PiyushChoudhary-Git/Tuned-Mass-Damper/Pictures/Deflection.jpg

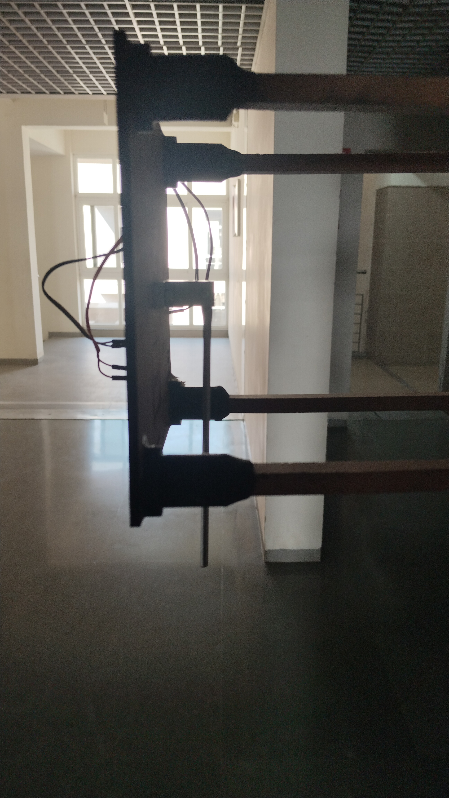
Pictures/Deflection.jpg
