PiyushChoudhary-Git/Tuned-Mass-Damper/Pictures/Model.jpg

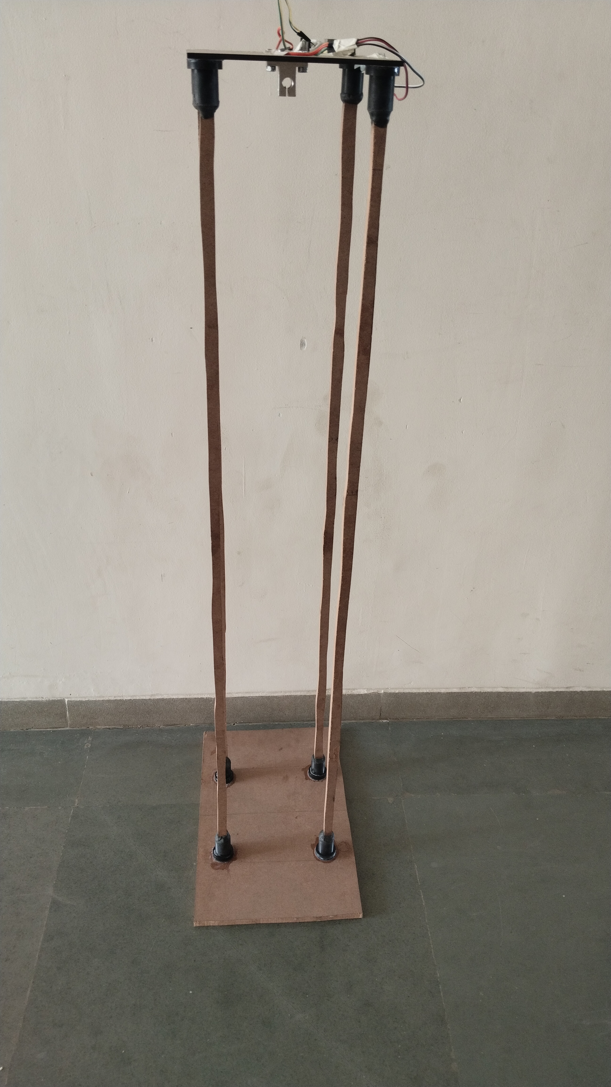
Pictures/Model.jpg
