PiyushChoudhary-Git/Tuned-Mass-Damper/CE302_Final_Report.pdf

# CE 302: Structural Analysis

### Project

### Report on

## Tuned Mass Damper

by

Team Name: STrUX

Himanshu Singh 23110134

Karthik Chandra 23110158

Piyush Choudhary 23110247

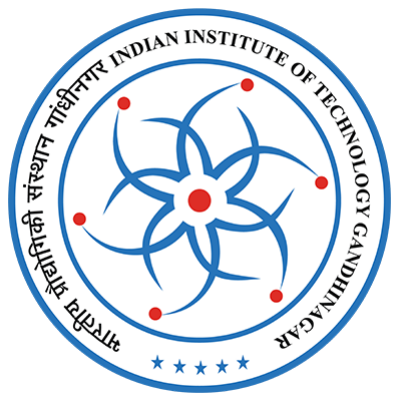
[picture p3: figure]

Indian Institute of Technology Gandhinagar

## Declaration

We, Himanshu Singh, Karthik Chandra, and Piyush Choudhary, declare that we have done the following proportion of work towards the project entitled “Tuned Mass Damper” of the Structural Analysis (CE 302) course.

Sl. No. | Name | Responsibilities | Percentage of Total Work | Signature
1 | Himanshu Singh | 3D Printed All Joints, Helped in Creating The Model, Did all the SAP Modelling | 33.33 %
2 | Karthik Chandra | Major Fabrication work and helped in report(Analytical results, summary and Conclusion) | 33.34 %
3 | Piyush Choudhary | Helped in Fabrication, Wrote the necessary Codes, Compiled the report and wrote the Experimental set-up and Comparison part | 33.33 %

## Acknowledgements

We would like to express our sincere gratitude to Prof. Manish Kumar, our course instructor for CE302 – Structural Analysis, for his valuable guidance, support, and encouragement throughout the course and this project.
We are also thankful to our Teaching Assistants, Krishnaveni Ma’am and Priya Ben Ma’am, for their continuous assistance.
Our heartfelt thanks to the Machine Shop Lab Instructors for providing us with the basic materials and technical support that were crucial for our work.
We would like to extend our gratitude to Abhhitej Singh Bhullar for kindly lending us an MDF sheet, which significantly aided in the fabrication of our model.
We are also grateful to the Tinkerer’s Lab for offering us the space and resources to carry out our project work in a conducive and creative environment.
This project would not have been possible without the support and contributions of all the above individuals and facilities.

# Contents

1 Introduction | 8
2 Analytical results | 11
3 SAP2000 model | 13
4 Experimental set-up, testing protocol and results | 19

5 Comparison of analytical and experimental results | 24
6 Summary and conclusions | 27
7 References | 28
8 Appendix | 29

# List of Tables

1.1 Components of a Tuned Mass Damper | 9
4.1 Experimental damping ratios | 23

# List of Figures

1.1 TMD in a building | 9
3.1 Initial handmade draft of the TMD system | 13
3.2 Top view of the SAP model | 14
3.3 Side view of the SAP model | 14
3.4 3D model of skyscraper with TMD (green line represents the damper) | 15
3.5 Side view of the skyscraper | 16
3.6 Deflection In The Building Due To Applied Earthquake Load | 17
3.7 Energy dissipation with TMD | 18
3.8 Energy dissipation without TMD | 18
4.1 Model without TMD | 19
4.2 Model with TMD | 19
4.3 Arduino Connections with Accelerometer [1] | 20
4.4 Acceleration Decay for Model (Without TMD) | 21
4.5 Acceleration Decay for Model (With TMD) | 21
4.6 Deflection taking the structure as Cantilevered beam | 22
5.1 Graph with and without TMD (on same scale) | 26
8.1 All the files, images and pdf version of report can be accessed here | 36

1

# Introduction

## 1.1 The Problem: Why Do Buildings Sway?

Tall structures such as skyscrapers are inherently flexible, like vertical cantilevers that oscillate when subjected to dynamic loads like wind or seismic activity. These structures possess a natural frequency (ωn), a property determined by their stiffness (k) and mass (m):

ωn =

r
k
m

When external forces (e.g., wind gusts or earthquakes) apply periodic excitation at a forcing frequency (ωext) matching the structure’s natural frequency, resonance occurs:

ωext ≈ ωn

At resonance, energy transfer to the structure becomes highly efficient, causing displacements to amplify exponentially. For lightly damped systems, this can lead to structural fatigue, occupant discomfort, or even catastrophic failure.

### 1.1.1 Amplitude of Vibration (Without a TMD)

The displacement response (x) of a building under a harmonic force F0 cos(ωt) is modeled by the damped harmonic oscillator equation:

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
+kx = F0 cos(ωt)

where c is the damping coefficient. At resonance (ω = ωn), the steady-state amplitude A reaches its maximum:
A =

F0
2mωnζ

, ζ =

c
2

√
km
Here, ζ is the damping ratio. For typical civil structures (ζ ≈ 1–5%), the amplitude A can become dangerously large, necessitating mitigation strategies.

## 1.2 The Solution: Tuned Mass Damper (TMD)

### 1.2.1 Principle of Operation

A Tuned Mass Damper (TMD) is a passive vibration control device consisting of a secondary mass (md), spring (kd), and damper (cd) installed atop a structure (see Figure 1.1). The TMD is tuned to the structure’s natural frequency (ωd = ωn), enabling it to oscillate out of phase with the building’s motion. This generates destructive interference, effectively canceling resonant vibrations.

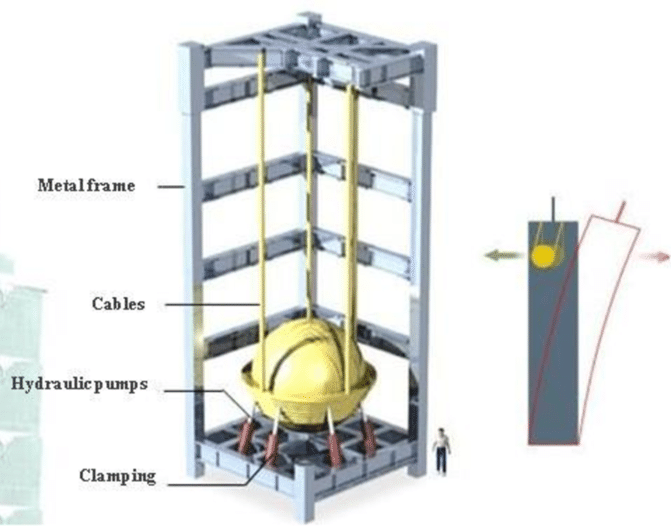
[picture p4: figure]

Figure 1.1: TMD in a building

Key Components

Component | Function
Mass | Counterweight (1–5% of structural mass) to absorb kinetic energy
Spring | p kd/md) Tuned to match the building’s natural frequency (ωd =
Damper | Dissipates energy via viscous damping, converting oscillations into heat

Table 1.1: Components of a Tuned Mass Damper

### 1.2.2 Mathematical Modeling [2]

The coupled building-TMD system is governed by two equations of motion:

Building Dynamics

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
+kx−cd

dy
dt

−

dx

dt
−kd(y−x) = F0 cos(ωt)

TMD Dynamics

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
+kd(y−x) = 0

Here, x(t) and y(t) represent the displacements of the building and TMD, respectively. The TMD exerts opposing forces proportional to the relative displacement (y−x) and velocity ( ˙y−x˙), counteracting the building’s motion.

### 1.2.3 Mechanism of Destructive Interference

When the building sways right (+x), the TMD lags by half a cycle, swaying left (−y). This phase difference of 180◦
ensures the TMD’s inertial force opposes the building’s motion:

FTMD = −kd(y−x)−cd

d
dt

(y−x)

The net force on the building becomes:

Fnet = Fwind +FTMD

thereby reducing the effective amplitude x.

### 1.2.4 Design Considerations

The TMD’s effectiveness hinges on three parameters:

1. Mass Ratio (µ = md/m):
A larger mass (typically 1–5% of the building’s mass) improves energy absorption but increases cost and space requirements.
2. Tuning Accuracy:
Mismatch between ωd and ωn drastically reduces performance. Post-construction tuning via adjustable springs/pendulums is critical.
3. Optimal Damping (ζd):
Excessive damping restricts TMD motion, while insufficient damping fails to dissipate energy. The optimal damping ratio is derived as:

ζd =

s
3µ
8(1+ µ)

### 1.2.5 Practical Applications

The Taipei 101 skyscraper employs a 660-tonne spherical TMD, reducing peak accelerations by 30–40% during typhoons. Similarly, the Citicorp Center in New York uses a 400-ton TMD to mitigate windinduced oscillations.

2

# Analytical results

## 2.1 Deflection Angle (θ)

The cantilever beam is analyzed under its self-weight (Assuming the roof and the electronic components are mass-less), modeled as a uniformly distributed load (UDL). The following parameters are considered:

- Length (L) = 1.2 m
- Breadth (b) = 1.5 cm = 0.015 m
- Depth (d) = 1 cm = 0.01 m
- Young’s Modulus (E) = 4 GPa = 4×10⁹ Pa
- Density (ρ) = 725 kg/m³
- Moment of Inertia (I) =

bd³

12

=

0.015×(0.01)

3

12

= 1.25×10⁻⁹ m⁴

- Uniformly Distributed Load (w) =

ρ·g·V
L = 725 · 9.81 ·(0.015 · 0.01) = 1.06575 N/m

The theoretical deflection angle at the free end is given by:

| θ = wL³
| 6EI

Substituting values:

θ =

1.06575×(1.2)

3
6×4×10⁹ ×1.25×10⁻⁹
| ≈ 0.06138 radians ≈ 3.5168◦

## 2.2 Natural Frequency Analysis

To assess the dynamic behavior of the beam, time-domain acceleration data was recorded for two conditions:

- With Tuned Mass Damper (TMD)
- Without Tuned Mass Damper

To evaluate the natural frequency of the beam, we analyzed the time-domain acceleration data and identified the time between the first two peaks of vibration. The time period (T) was calculated as:

T = t2 −t1

where t1 and t2 are the time values corresponding to the first and second peaks, respectively. Using the relationship:

f =

1
T
we estimated the natural frequencies for both cases. Results:
- Without TMD: Natural Frequency ≈ 2.88 Hz
- With TMD: Natural Frequency ≈ 2.50 Hz

3

# SAP2000 model

We began by carefully deciding the dimensions for our model to meet the structural and damping requirements. The initial concept was sketched by hand to finalize proportions and design intent.

## 3.1 Handmade Draft

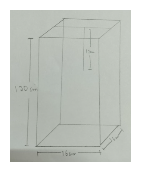
[picture p5: figure]

Figure 3.1: Initial handmade draft of the TMD system.

## 3.2 SAP2000 Modeling

After finalizing the design, we created the structure in SAP2000 using the same dimensions and configuration as the handmade draft.

### 3.2.1 Top View of the SAP Model

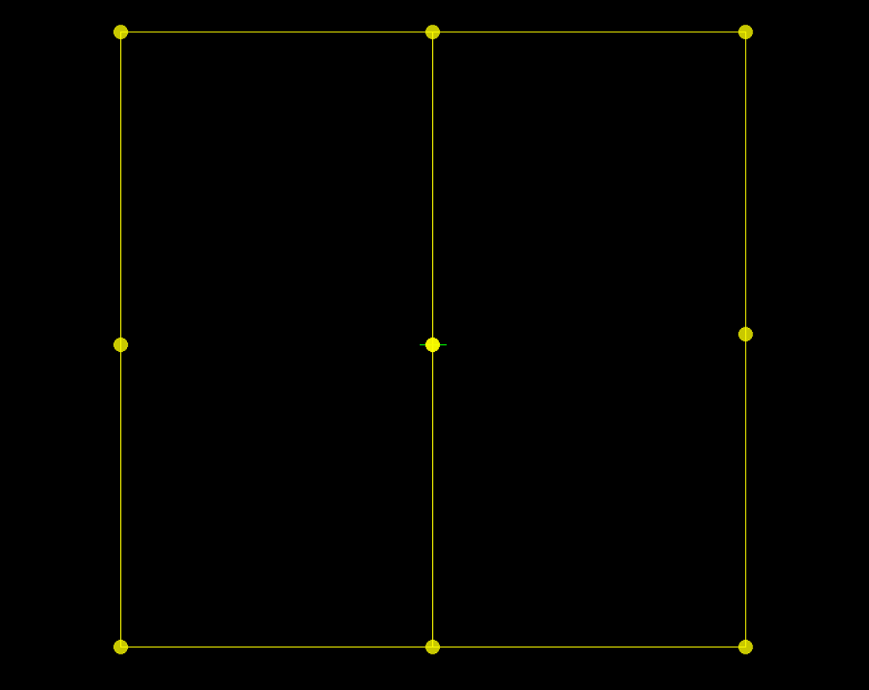
[picture p6: figure]

Figure 3.2: Top view of the SAP model.

### 3.2.2 Side View of the SAP Model

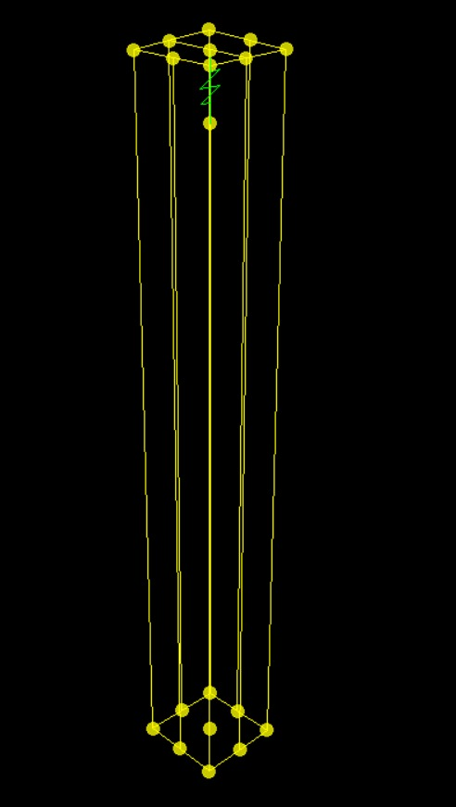
[picture p7: figure]

Figure 3.3: Side view of the SAP model.

### 3.2.3 Full Skyscraper with TMD

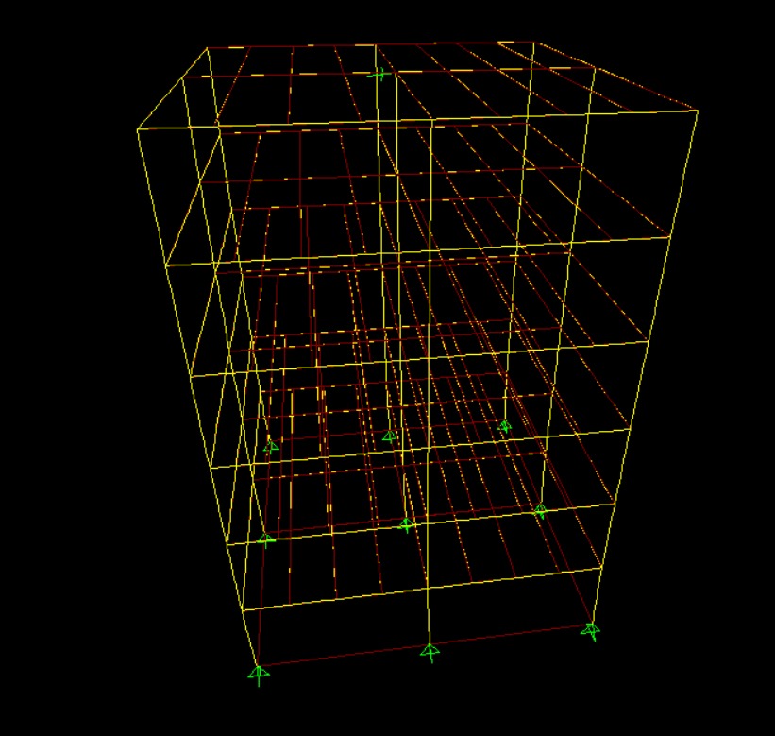
[picture p8: figure]

Figure 3.4: 3D model of skyscraper with TMD (green line represents the damper).

### 3.2.4 Side View of the Skyscraper

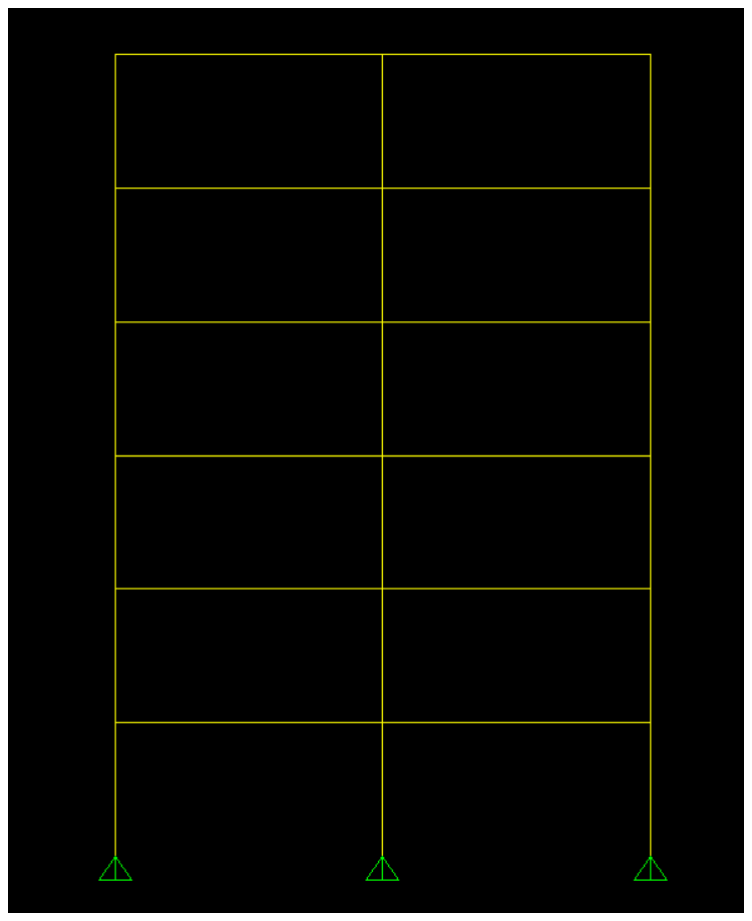
[picture p9: figure]

Figure 3.5: Side view of the skyscraper.

## 3.3 Earthquake Load Simulation

We applied earthquake loads to the structure and visualized the resulting deflections. The model responded realistically, showing clear differences in behavior with and without the TMD.

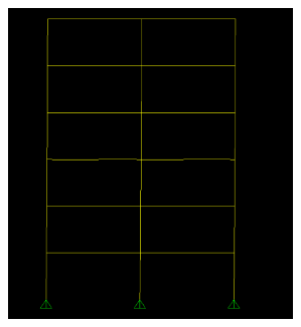
[picture p10: figure]

Figure 3.6: Deflection In The Building Due To Applied Earthquake Load.

## 3.4 Energy Dissipation Comparison

We analyzed the time taken for the building’s kinetic energy to reduce to zero, with and without the damper.

## 3.5 Observation

From the simulation results:

- With TMD: The kinetic energy reduces to zero in approximately 2.6 seconds.
- Without TMD: The building takes slightly more than 3 seconds to stabilize.

This confirms that the TMD significantly enhances the damping performance of the structure.

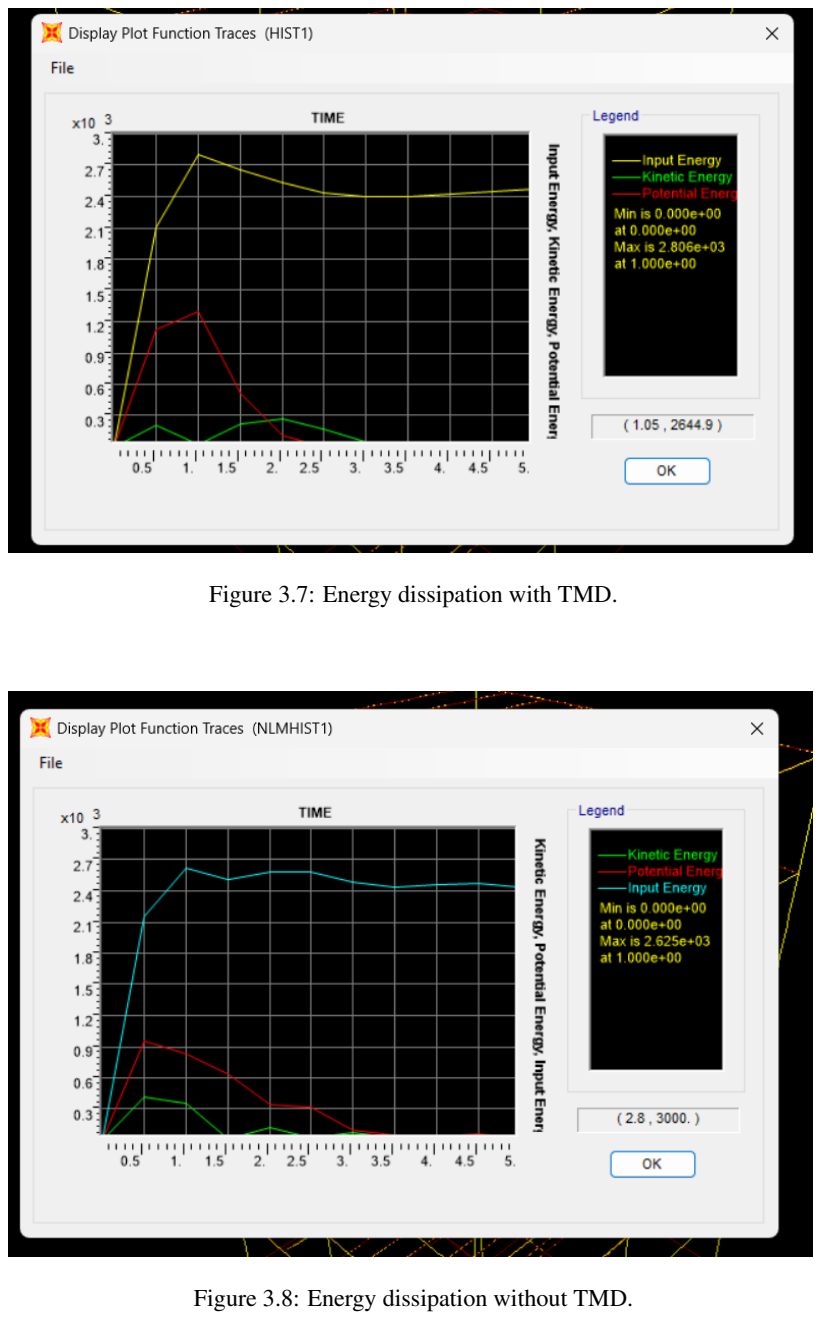
[picture p11: page 18]

Figure 3.7: Energy dissipation with TMD.

Figure 3.8: Energy dissipation without TMD.

4

# Experimental set-up, testing protocol and results

## 4.1 Experimental Setup

### 4.1.1 Physical Model

A scaled-down building model was constructed with the following components:

- Primary structure: MDF sheet was used and joints were 3D printed.
- TMD attachment: Removable mass-damper system (tuned to the model’s natural frequency).
- Sensors: Accelerometer (MPU6050) mounted at the top floor to measure lateral acceleration.
- Data acquisition: Arduino Uno programmed to sample acceleration data.

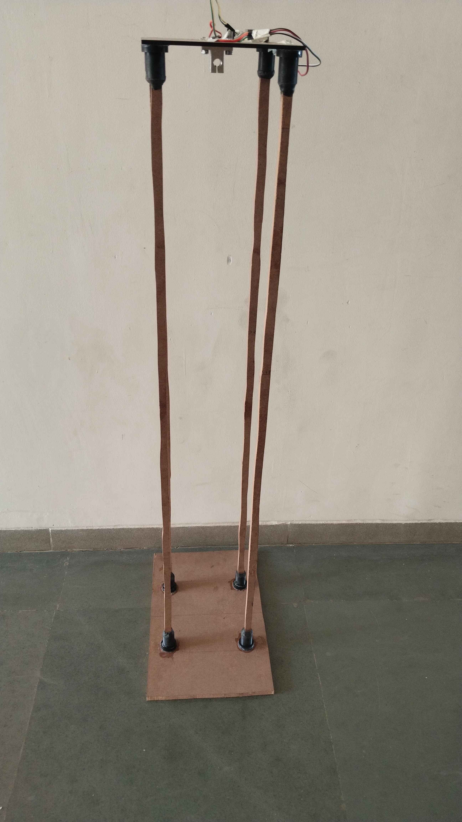
[picture p12: figure]
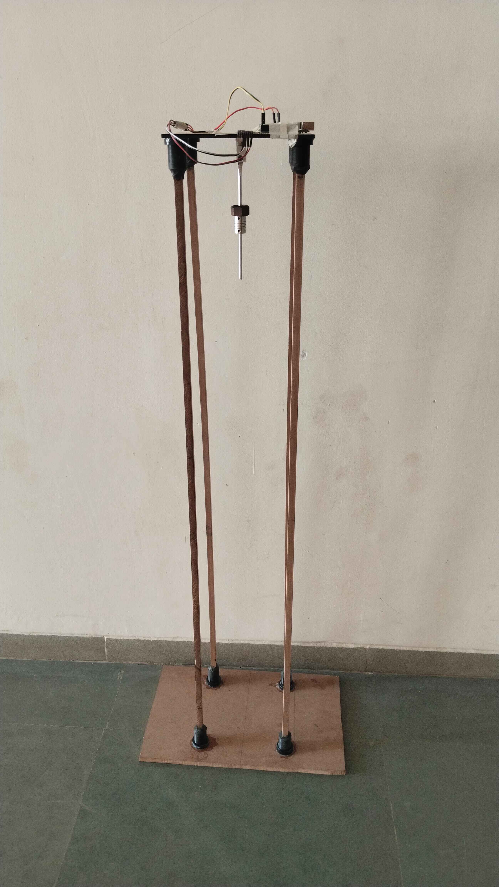
[picture p13: figure]

Figure 4.1: Model without TMD | Figure 4.2: Model with TMD

### 4.1.2 Software Tools

- Arduino IDE: Script was written to print the accelerometer data for all 3 axis. See Section 8.1 for more details.
- Python: Then python was used to filter out the data from lateral direction, plot and store the real time data (Section 8.2). Then the final code gives the Logarithmic Decrement constant (δ) and Damping Ratio (ζ ) (Section 8.3).

### 4.1.3 Arduino Connections

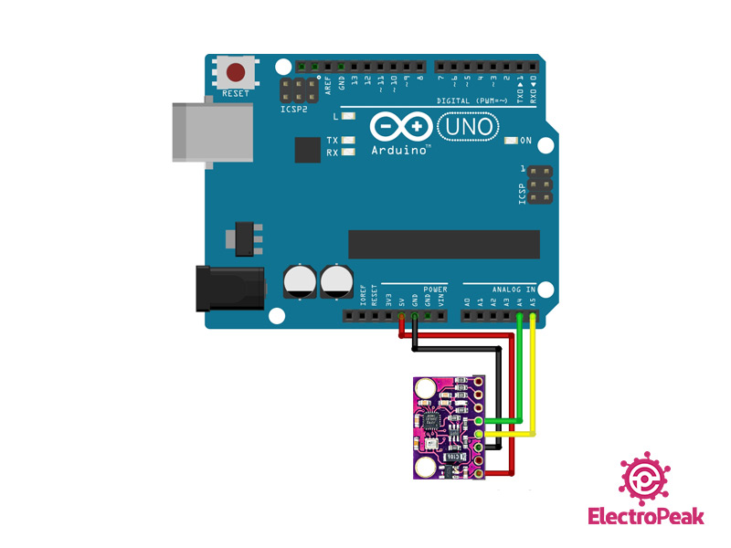
[picture p14: figure]

Figure 4.3: Arduino Connections with Accelerometer [1]

## 4.2 Testing Protocol

### 4.2.1 Baseline Damping Ratio (Without TMD)

1. Initial displacement: Manually displace the model by a fixed x.
2. Free vibration: Release the model and record acceleration till the acceleration becomes almost 0.
3. Peak detection: Identify consecutive amplitude peaks x1, x2,..., xn from the decaying oscillation (see Figure 4.2.1).
4. Damping calculation: Compute damping ratio ζoriginal using logarithmic decrement:

δ =

ln
|x1|
|x2|

p2 − p1

, ζ =

δ
p
(2π)

2 +δ

2

where p1 and p2 are indices of adjacent peaks.

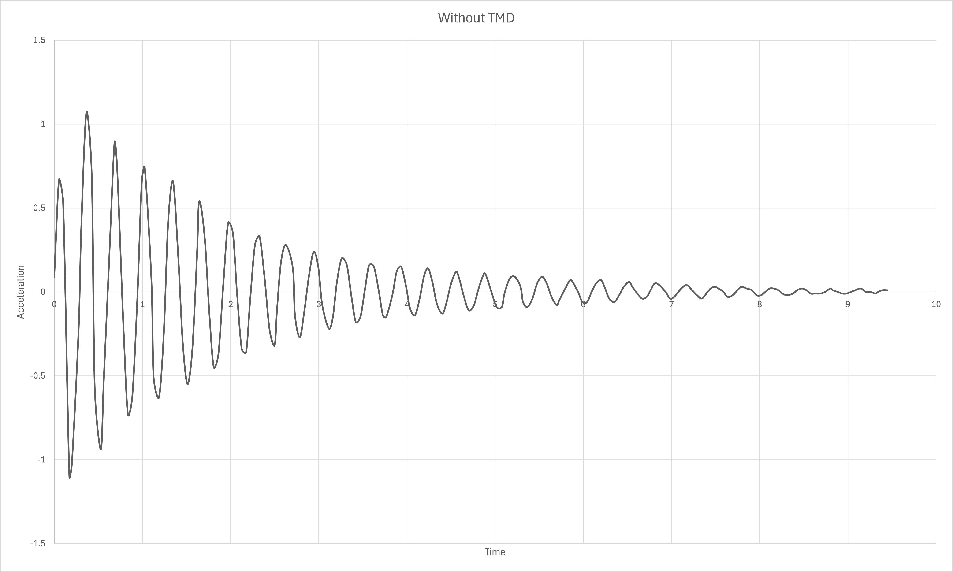
[picture p15: figure]

Figure 4.4: Acceleration Decay for Model (Without TMD)

### 4.2.2 TMD-Enhanced System

1. TMD installation: Attach the tuned mass damper to the model.
2. Repeat test: Displace the model by the same x, release, and record acceleration data.
3. Peak analysis: Extract peaks from the damped oscillation (see Figure 4.2.2).
4. Damping calculation: Derive the effective damping ratio ζTMD.

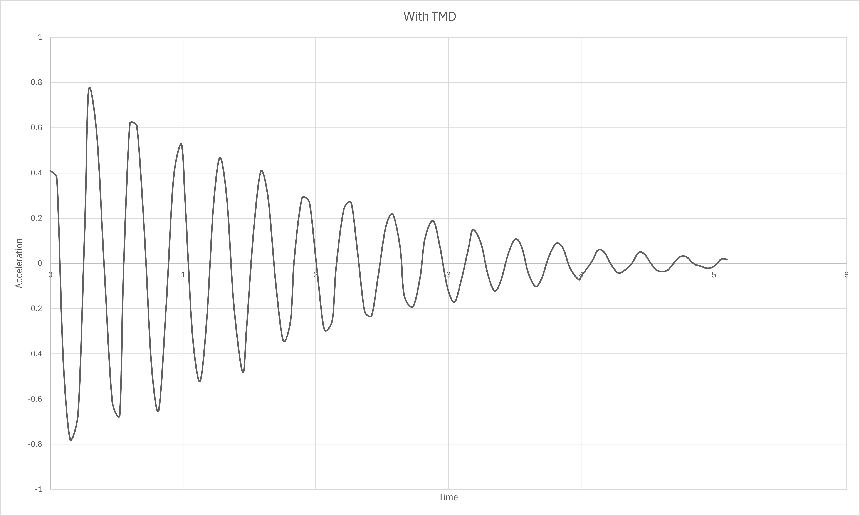
[picture p16: figure]

Figure 4.5: Acceleration Decay for Model (With TMD)

### 4.2.3 Deflection Angle Calculation (θ)

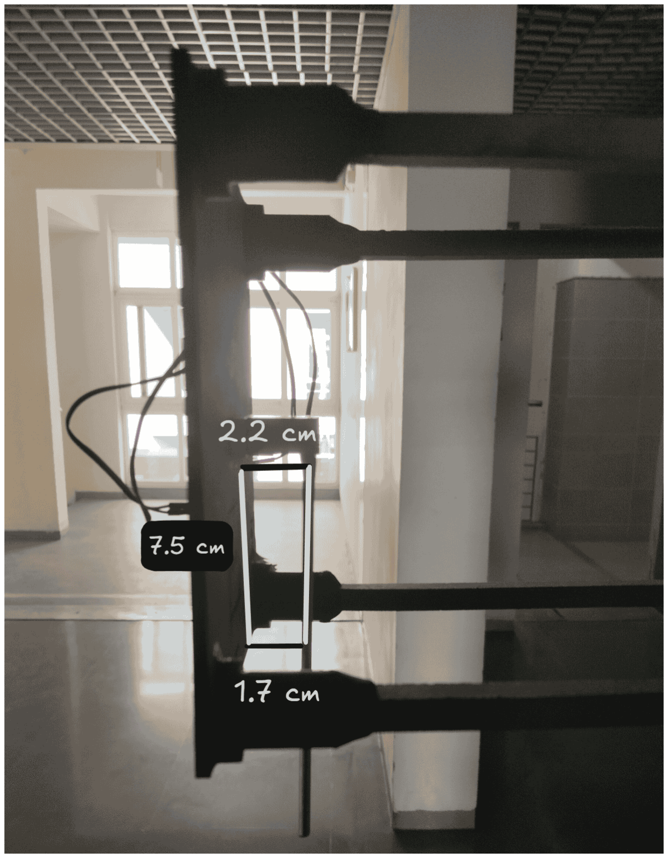
[picture p17: figure]

Figure 4.6: Deflection taking the structure as Cantilevered beam

To calculate the deflection angle θ of the TMD model due to gravity, we consider the given measurements: the horizontal displacements at two points along the pendulum, 2.2 cm and 1.7 cm, separated by a vertical distance of 7.5 cm. These measurements form a trapezoid with the parallel sides (horizontal displacements) being 2.2 cm and 1.7 cm, and the height (vertical distance) being 7.5 cm.

1. Determine the horizontal difference between the two points:

∆x = 2.2 cm−1.7 cm = 0.5 cm

2. Calculate the tangent of the deflection angle:
tan(θ) = | ∆x vertical distance
=

0.5 cm
7.5 cm =

1
15

≈ 0.0667

3. Find the tan⁻¹
to get the angle:
| θ = tan⁻¹
1

15
≈ 3.81◦

Thus, the deflection angle θ is 3.81◦ .

## 4.3 Results

### 4.3.1 Damping Ratio Comparison

Parameter | Without TMD | With TMD
Peak 1 amplitude (x1) | 0.6703 m/s² | 0.7679 m/s²
Peak 2 amplitude (x2) | 0.1203 m/s² | 0.0279 m/s²
Logarithmic decrement (δ) | 0.1227 | 0.2368
Damping ratio (ζ ) | 1.95% | 3.77%

Table 4.1: Experimental damping ratios

### 4.3.2 Key Observations

- Amplitude decay: The TMD reduced the amplitude by 96.4% between the first and second peaks, compared to 82% without TMD.
- Damping enhancement: The effective damping ratio increased from ζoriginal = 1.95% to ζTMD = 3.77%, demonstrating the TMD’s energy dissipation capability.

## 4.4 Discussion

The TMD introduces two damping mechanisms:

1. Structural damping: Intrinsic energy loss in the building materials.
2. Destructive Interference: When the building reaches one of its extreme position then TMD is at its other extreme position and vice-versa.

The doubling(almost) of ζ confirms that the TMD actively participates in energy dissipation rather than merely adding mass. This aligns with the theoretical principle of mass-spring phase opposition, where the TMD’s motion generates destructive interference.

5

# Comparison of analytical and experimental results

## 5.1 Deflection Angle (θ)

Theoretical Value: 3.5168◦ Observed Value: 3.8140748◦

Percentage Deviation:
3.8140748−3.5168
3.5168

×100 ≈ 8.45%

The observed and theoretical values are in good agreement, with a small deviation attributed to experimental conditions and assuming roof, arduino and other electronic components to be massless.

## 5.2 Natural Frequency Analysis

Analytical Results:

- Without TMD: Natural Frequency ≈ 2.88 Hz
- With TMD: Natural Frequency ≈ 2.50 Hz

Experimental(Manual) Results:

- Both cases: Natural Frequency ≈ 3 Hz

Since there is error factor in Manual Calculations of Natural Frequency due to obvious reasons.
In the ideal theoretical model, adding a TMD does not significantly change the primary natural frequency of the structure. Instead, it causes a splitting of modes, resulting in two closely spaced natural frequencies: one slightly below and one slightly above the original frequency. The energy shifts to these new modes, and the response at the original frequency is suppressed.
But, our model shows a noticeable decrease in natural frequency from 2.88 Hz → 2.50 Hz, which is a ∼ 13% reduction.

## 5.3 Damping Ratio

To quantify the damping characteristics of the a sky scraper like system, experiments were conducted in two phases: without and with a Tuned Mass Damper (TMD).

### 5.3.1 Baseline Damping (Without TMD)

The structure was displaced manually and released to undergo free vibration. Acceleration data was recorded until the system reached equilibrium. From the decaying oscillation curve, the first two consecutive peaks (x1 and x2) were extracted.

- Peak 1 Amplitude (x1): 0.6703 m/s²
- Peak 2 Amplitude (x2): 0.1203 m/s²
- Logarithmic Decrement (δ):

δ = ln
|x1|
|x2|

= ln
0.6703

0.1203
≈ 1.825
- Damping Ratio (ζ ):

ζ =

δ
p
(2π)

2 +δ

2

=

1.825
p
(2π)

2 + (1.825)

2

≈ 0.0195 or 1.95%

### 5.3.2 TMD-Enhanced System

With the TMD installed, the same test procedure was followed. The resulting acceleration data revealed significantly increased damping:

- Peak 1 Amplitude (x1): 0.7679 m/s²
- Peak 2 Amplitude (x2): 0.0279 m/s²
- Logarithmic Decrement (δ):
δ = ln
0.7679

0.0279
≈ 3.278
- Damping Ratio (ζ ):
ζ =

3.278
p
(2π)

2 + (3.278)

2

≈ 0.0377 or 3.77%

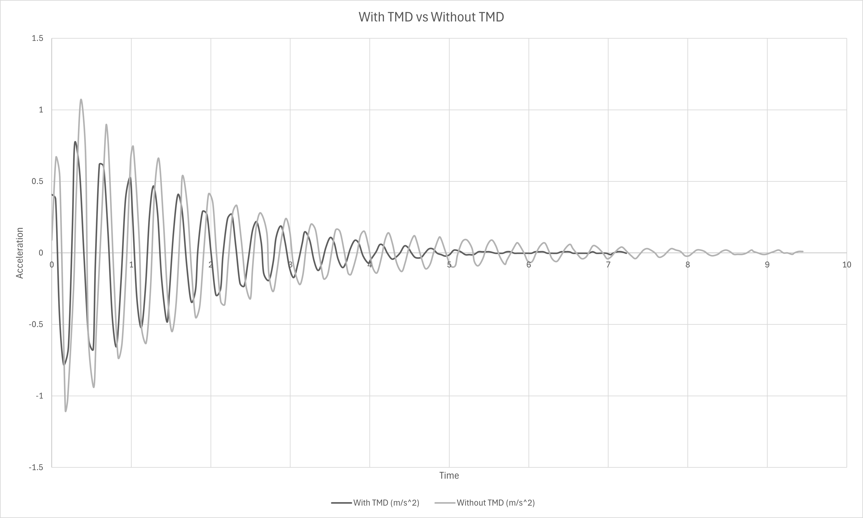
[picture p18: figure]

Figure 5.1: Graph with and without TMD (on same scale)

The damping ratio increased from 1.95% without TMD to 3.77% with TMD. This confirms the TMD’s effectiveness in dissipating vibrational energy, making the system more stable.

6

# Summary and conclusions

This project aimed to investigate the effectiveness of a Tuned Mass Damper (TMD) in reducing structural vibrations in a skyscraper like system modeled both physically and analytically.
A physical model was constructed, equipped with accelerometers and a data acquisition system using Arduino. Parallelly, analytical calculations were carried out to determine the deflection angle, natural frequency, and damping ratio of the system with and without a TMD. A SAP2000 model of a simplified skyscraper was created to simulate real-world scenarios, allowing visualization of the structural response under earthquake loads.
The experimental observations were in close agreement with analytical predictions. The theoretical deflection angle was calculated to be approximately 3.5168◦

, while the observed angle was 3.814◦ ,
showing a deviation of about 8.45% from the theoretical value. The natural frequency dropped from 2.88 Hz to 2.50 Hz upon adding the TMD. Most significantly, the damping ratio nearly doubled—from 1.95% without the TMD to 3.77% with it—highlighting a clear improvement in energy dissipation capability. Simulations in SAP2000 further reinforced these findings. The skyscraper model with TMD stabilized in 2.6 seconds, while the same structure without TMD took over 3 seconds to dissipate kinetic energy. This validated the damping enhancement and vibration control provided by the TMD in a real-world application.
In conclusion, both experimental and simulation-based results affirmed that the TMD significantly improves the dynamic performance of structures by reducing peak responses and increasing damping. This project not only demonstrated the practicality and efficiency of TMDs in structural systems but also laid a strong foundation for future work involving forced vibration testing, non-linear damping analysis, and optimization of mass-damper configurations for real-world deployment.

7

# References

[1] Electropeak. GY-91 IMU Module Wiring Diagram. https : / / electropeak . com / learn / wp -content/uploads/2020/11/GY91-IMU-wire.jpg. (https://electropeak.com/learn/wp-content/uploads/2020/11/GY91-IMU-wire.jpg) Accessed: 2025-04-16. 2020.
[2] Purdue University. Intro to Structural Motion Control – Chapter 4. https : / / engineering . purdue . edu / ~ce573 / Documents / Intro % 20to % 20Structural % 20Motion % 20Control _ Chapter4.pdf. (https://engineering.purdue.edu/~ce573/Documents/Intro%20to%20Structural%20Motion%20Control_Chapter4.pdf) Accessed: 2025-04-16. 2020.

8

# Appendix

## 8.1 Arduino Code

#include <MPU9250_asukiaaa.h> #include <Adafruit_BMP280.h> #ifdef _ESP32_HAL_I2C_H_

#define SDA_PIN 21

#define SCL_PIN 22

#endif

Adafruit_BMP280 bmp;
MPU9250_asukiaaa mySensor;

float aX, aY, aZ, aSqrt;
void setup()
{
Serial.begin(115200);
while (!Serial)
;

#ifdef _ESP32_HAL_I2C_H_

Wire.begin(SDA_PIN, SCL_PIN); mySensor.setWire(&Wire);
#else

Wire.begin();
mySensor.setWire(&Wire);
#endif

bmp.begin();
mySensor.beginAccel();
}

void loop()
{
if (mySensor.accelUpdate() == 0) {aX = mySensor.accelX();
aY = mySensor.accelY();
aZ = mySensor.accelZ();
aSqrt = mySensor.accelSqrt(); Serial.print(String(aX));
Serial.print("\t" + String(aY)); Serial.print("\t" + String(aZ)); Serial.println();}
delay(50);}

## 8.2 Plot real time data & storing CSV

import serial
import matplotlib.pyplot as plt
from matplotlib.animation import FuncAnimation import collections
import time
import csv

SERIAL_PORT = "COM5"
BAUD_RATE = 115200
NUM_OFFSET_SAMPLES = 100
Y_AXIS_MIN = -5
Y_AXIS_MAX = 5
DATA_WINDOW_SIZE = 200
CSV_FILE_NAME = "acceleration_data.csv"

def compute_offset(ser, num_samples):
offset_samples = []
18 | print(f"Collecting {num_samples} samples | offseted...")
| while len(offset_samples) < num_samples:
| try:
line = ser.readline().decode('utf-8').strip()
| if line: parts = line.split()
| if len(parts) >= 2:
| y_val = float(parts[1])
offset_samples.append(y_val)
| except Exception as e: print("Parsing error:", e)

offset = sum(offset_samples) / len(offset_samples) print(f"Computed y-axis offset: {offset:.4f}")
| return offset
| def main():
| try:
ser = serial.Serial(SERIAL_PORT, BAUD_RATE, timeout=1)
| time.sleep(2)
| except Exception as e:
print("Failed to open serial port:", e)
| return

y_offset = compute_offset(ser, NUM_OFFSET_SAMPLES)
y_data = collections.deque([0] * DATA_WINDOW_SIZE, maxlen=DATA_WINDOW_SIZE) x_time_data = collections.deque([0] * DATA_WINDOW_SIZE, maxlen=DATA_WINDOW_SIZE)

45 | start_time = time.time()
46 | csv_file = open(CSV_FILE_NAME, mode='w', newline='')
47 | csv_writer = csv.writer(csv_file)
48 | csv_writer.writerow(["Time (ms)", "Acceleration (m/s^2)"])

49
50 | fig, ax = plt.subplots()
51 | line_plot, = ax.plot([], [], lw=1.5)
52 | ax.set_ylim(Y_AXIS_MIN, Y_AXIS_MAX)
53 | ax.set_title("Acceleration vs Time")
54 | ax.set_xlabel("Time (s)")
55 | ax.set_ylabel("Acceleration (m/s²)")

56
57 | def update(frame):
58 | current_time = time.time() - start_time
59 | try:
60 | while ser.in_waiting:
61 | line_in = ser.readline().decode('utf-8').strip()
62 | if line_in:
63 | parts = line_in.split()
64 | if len(parts) >= 2:
65 | y_val = float(parts[1])
66 | y_val_adj = y_val - y_offset
67 | y_data.append(y_val_adj)
68 | x_time_data.append(current_time)
69 | current_time_ms = int(current_time * 1000)
70 | csv_writer.writerow([current_time_ms, y_val_adj])

71
72 | line_plot.set_data(x_time_data, y_data)
73 | ax.set_xlim(max(0, current_time - (DATA_WINDOW_SIZE * 0.05)), current_time)
74 | except Exception as e:
75 | print("Error reading/updating data:", e)
76 | return line_plot,

77
78 | ani = FuncAnimation(fig, update, interval=10)
79 | plt.show()
80 | ser.close()

81
82 | if __name__ == "__main__":
83 | main()

## 8.3 Damping Ratio Calculator

import pandas as pd
import numpy as np
import matplotlib.pyplot as plt from scipy.signal import find_peaks # attach csv file
df = pd.read_csv("test1.csv") df["Time (s)"] = df["Time"] / 1000.0

time = df["Time"].values
acc = df["Acceleration"].values
peaks, _ = find_peaks(acc, distance=1)

plt.plot(time, acc, label="Acceleration") plt.plot(time[peaks], acc[peaks], "ro", label="Peaks") plt.xlabel("Time")
plt.ylabel("Acceleration")
plt.title("Acceleration Peaks")
plt.legend()
plt.grid(True)
plt.show()

if len(peaks) >= 15:
p1=1
p2=14
x1 = acc[peaks[p1]]
x2 = acc[peaks[p2]]
delta = np.log(abs(x1 / x2))/(p2-p1)
zeta = delta / np.sqrt((2 * np.pi)**2 + delta**2)

print(f"Peak 1 Amplitude: {x1:.4f}") print(f"Peak 2 Amplitude: {x2:.4f}") print(f"Logarithmic Decrement (): {delta:.4f}") print(f"Damping Ratio (): {zeta:.4f}")
else:
print("Not enough peaks to compute damping.")

## 8.4 Data Tables

### 8.4.1 Without TMD

Time | Acceleration
0 | 0.0903
0.054 | 0.6703
0.101 | 0.5303
0.171 | -1.0997
0.199 | -1.0297
0.275 | -0.2397
0.307 | 0.3903
0.365 | 1.0703
0.425 | 0.7003
0.46 | -0.5797
0.528 | -0.9397
0.562 | -0.5197
0.62 | 0.1603
0.683 | 0.8903
0.713 | 0.7403
0.784 | -0.1997
0.835 | -0.7297
0.884 | -0.6297
0.938 | -0.0897
0.992 | 0.6503
1.026 | 0.7403
1.102 | 0.0703
1.127 | -0.5097
1.187 | -0.6297
1.242 | -0.2497
1.292 | 0.4203
1.346 | 0.6603
1.404 | 0.2303
1.458 | -0.3097
1.512 | -0.5497
1.565 | -0.3497
1.619 | 0.2203
1.644 | 0.5403
1.705 | 0.3303
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
4.175 | 0.0479
4.222 | -0.0021
4.277 | -0.0421
4.324 | -0.0321
4.379 | -0.0021
4.434 | 0.0479
4.481 | 0.0379
4.527 | -0.0021
4.574 | -0.0321
4.645 | -0.0321
4.693 | -0.0021
4.743 | 0.0279
4.794 | 0.0279
4.849 | -0.0021
4.9 | -0.0121
4.952 | -0.0221
5.004 | -0.0121
5.054 | 0.0179
5.1 | 0.0179

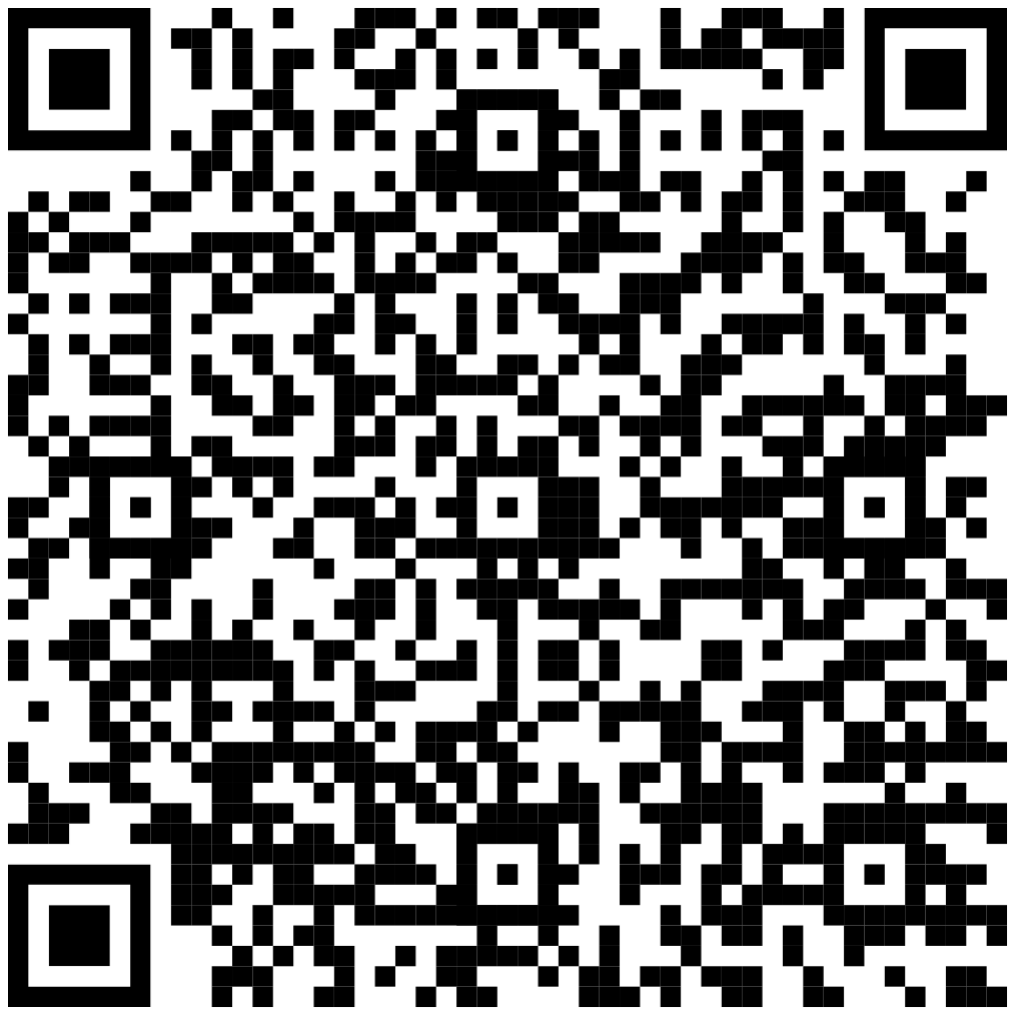
[picture p19: figure]

Figure 8.1: All the files, images and pdf version of report can be accessed here
