PiyushChoudhary-Git/Tuned-Mass-Damper/Pictures/Model_t.jpg

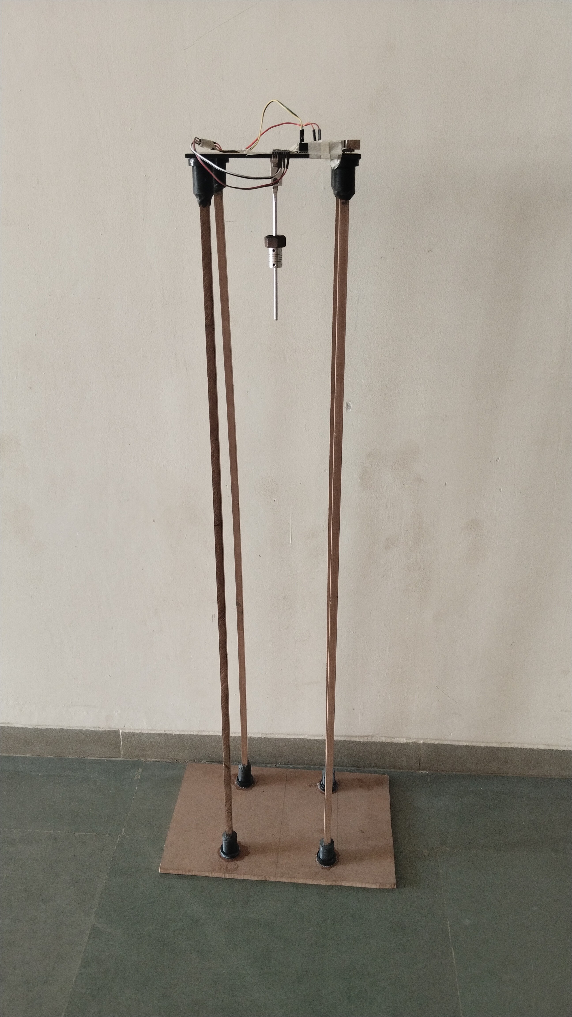
Pictures/Model_t.jpg
